dekomote/boop/fab/bom.csv

Comment | Designator | Footprint | LCSC Part #
10uF 25V | C1 | Capacitor_SMD:C_1206_3216Metric | C9807
1N5819HW-7-F | D1 | Diode_SMD:D_SOD-123 | C82544
1N4148W | D2,D3 | Diode_SMD:D_SOD-123 | C2099
1N4148WS | D4 | Diode_SMD:D_SOD-323 | C2128
5V_IN (+/-) | J1 | Connector_JST:JST_XH_B2B-XH-A_1x02_P2.50mm_Vertical | C158012
PWR_TO_MB | J2 | Connector_PinHeader_2.54mm:PinHeader_1x02_P2.54mm_Vertical | C492401
PWR_FROM_CASE | J3 | Connector_PinHeader_2.54mm:PinHeader_1x02_P2.54mm_Vertical | C492401
RST_TO_MB | J4 | Connector_PinHeader_2.54mm:PinHeader_1x02_P2.54mm_Vertical | C492401
RST_FROM_CASE | J5 | Connector_PinHeader_2.54mm:PinHeader_1x02_P2.54mm_Vertical | C492401
XIAO_LEFT_D0-D6 | J6 | Connector_PinSocket_2.54mm:PinSocket_1x07_P2.54mm_Vertical | C2897370
XIAO_RIGHT_5V-D7 | J7 | Connector_PinSocket_2.54mm:PinSocket_1x07_P2.54mm_Vertical | C2897370
PLED_FROM_MB | J8 | Connector_PinHeader_2.54mm:PinHeader_1x02_P2.54mm_Vertical | C492401
PLED_TO_CASE | J9 | Connector_PinHeader_2.54mm:PinHeader_1x02_P2.54mm_Vertical | C492401
G6K-2F-Y-TR DC4.5 | K1,K2 | Relay_SMD:Relay_DPDT_Omron_G6K-2F-Y | C397193
150 | R1,R2 | Resistor_SMD:R_0603_1608Metric | C22808
470 | R3 | Resistor_SMD:R_0603_1608Metric | C23179
10k | R4 | Resistor_SMD:R_0603_1608Metric | C25804
LTV-817S-TA1-D | U2,U3 | Package_DIP:SMDIP-4_W9.53mm | C114603
LTV-817S-TA1-C | U4 | Package_DIP:SMDIP-4_W9.53mm | C109227
