dekomote/boop/fab/BOM_full_with_wires.csv

Comment | Designator | Quantity | Footprint | LCSC Part # | Assembled by JLCPCB | Notes
10uF 25V | C1 | 1 | C_1206_3216Metric | C9807 | Yes
1N5819HW-7-F | D1 | 1 | D_SOD-123 | C82544 | Yes
1N4148W | D2,D3 | 2 | D_SOD-123 | C2099 | Yes
1N4148WS | D4 | 1 | D_SOD-323 | C2128 | Yes
5V_IN (+/-) | J1 | 1 | JST_XH_B2B-XH-A_1x02_P2.50mm_Vertical | C158012 | No - hand solder
PWR_TO_MB | J2 | 1 | PinHeader_1x02_P2.54mm_Vertical | C492401 | No - hand solder
PWR_FROM_CASE | J3 | 1 | PinHeader_1x02_P2.54mm_Vertical | C492401 | No - hand solder
RST_TO_MB | J4 | 1 | PinHeader_1x02_P2.54mm_Vertical | C492401 | No - hand solder
RST_FROM_CASE | J5 | 1 | PinHeader_1x02_P2.54mm_Vertical | C492401 | No - hand solder
XIAO_LEFT_D0-D6 | J6 | 1 | PinSocket_1x07_P2.54mm_Vertical | C2897370 | No - hand solder
XIAO_RIGHT_5V-D7 | J7 | 1 | PinSocket_1x07_P2.54mm_Vertical | C2897370 | No - hand solder
PLED_FROM_MB | J8 | 1 | PinHeader_1x02_P2.54mm_Vertical | C492401 | No - hand solder
PLED_TO_CASE | J9 | 1 | PinHeader_1x02_P2.54mm_Vertical | C492401 | No - hand solder
G6K-2F-Y-TR DC4.5 | K1,K2 | 2 | Relay_DPDT_Omron_G6K-2F-Y | C397193 | Yes
150 | R1,R2 | 2 | R_0603_1608Metric | C22808 | Yes
470 | R3 | 1 | R_0603_1608Metric | C23179 | Yes
10k | R4 | 1 | R_0603_1608Metric | C25804 | Yes
LTV-817S-TA1-D | U2,U3 | 2 | SMDIP-4_W9.53mm | C114603 | Yes
LTV-817S-TA1-C | U4 | 1 | SMDIP-4_W9.53mm | C109227 | Yes
Dupont wire, female-female, 20cm, 22AWG (1P) | W1,W2 | 2 | Wire | C368922 | No | J2 -> motherboard power switch header (polarity does not matter)
Dupont wire, female-female, 20cm, 22AWG (1P) | W3,W4 | 2 | Wire | C368922 | No | J4 -> motherboard reset switch header (polarity does not matter)
Dupont wire, female-female, 20cm, 22AWG (1P) | W5,W6 | 2 | Wire | C368922 | No | J8 -> motherboard power LED header: PLED+ to the pin marked +
Dupont wire, female-female, 20cm, 22AWG (1P) | W7,W8 | 2 | Wire | C368922 | No | Optional 5V feed. Cut one end off each, crimp into the XH housing below. Other ends go to motherboard USB header pin 1 (VCC, red) and pin 7 (GND, black)
JST XHP-2 housing (mates with J1) | P1 | 1 |  | C144401 | No | For the 5V feed cable
JST SXH-001T-P0.6 crimp terminal | P1 | 2 |  | C140573 | No | For the 5V feed cable, 22-28 AWG, needs a crimp tool
M3 standoff (length to suit your case) | H1-H4 | 4 |  |  | No | Not stocked by JLCPCB, buy anywhere
M3 screw (or nut + screw) | H1-H4 | 8 |  |  | No | Nylon is the safe choice, GND pour touches the hole edges
(no wire needed) | J3,J5,J9 | 3 |  |  |  | Plug straight into the case power, reset and power LED leads
