dekomote/boop/boop.kicad_pcb

## KiCad design boop.kicad_pcb (2026-10-27)

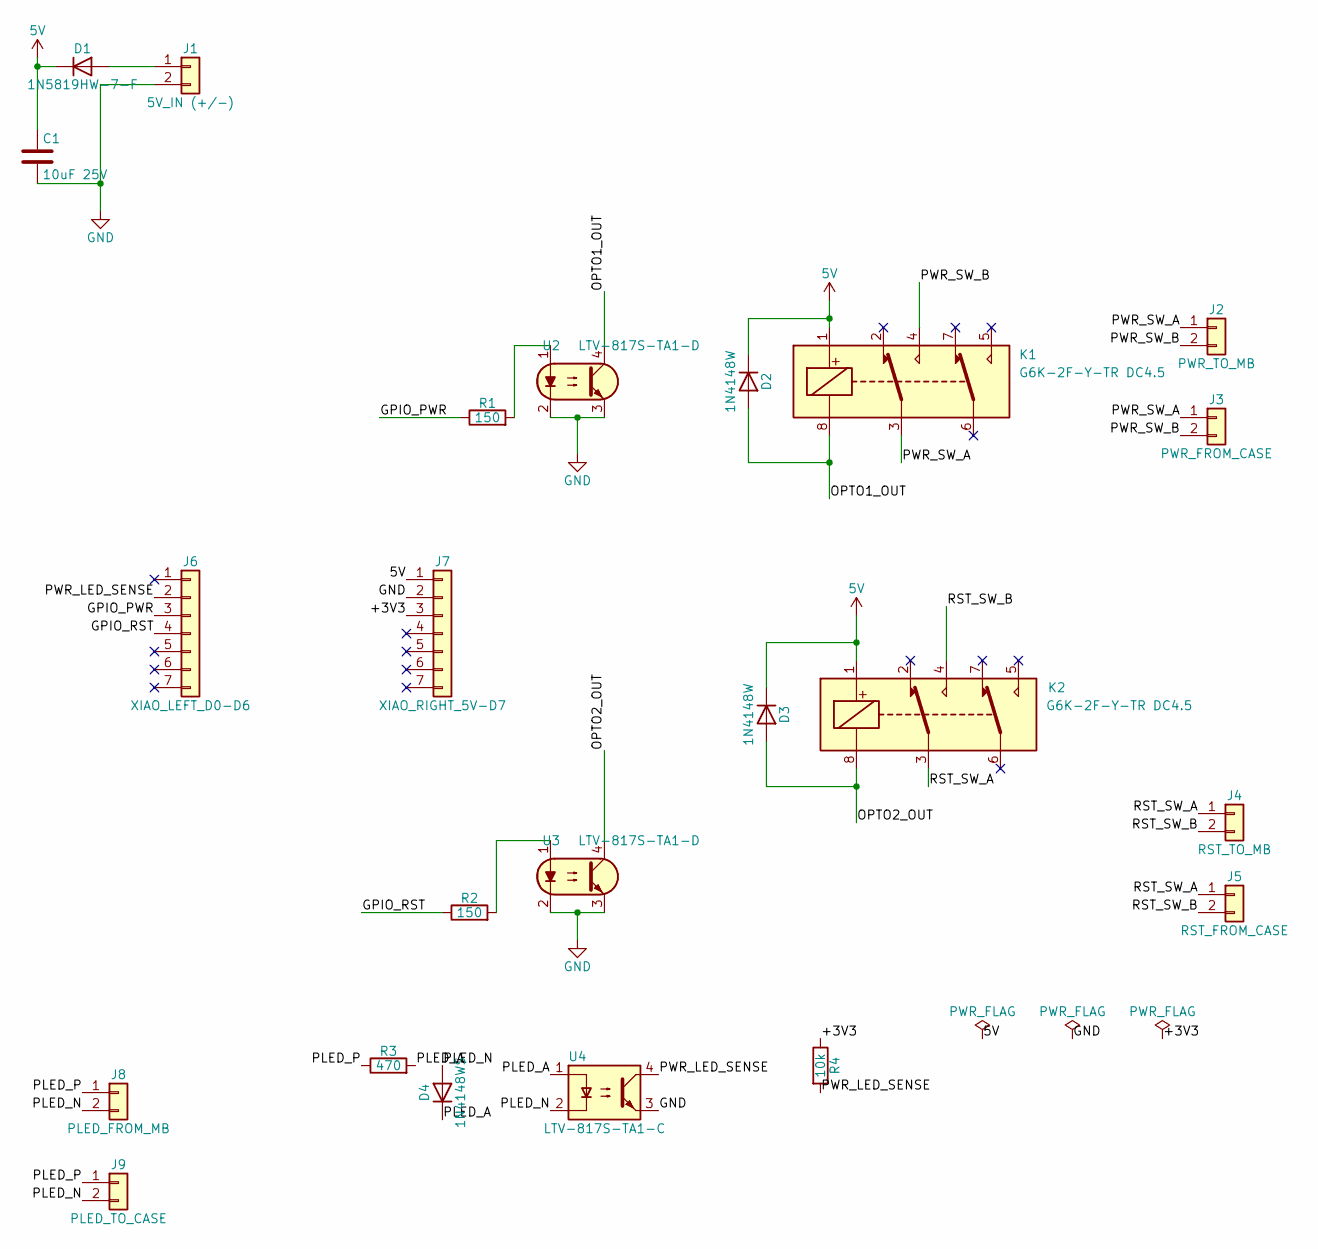
[picture p3: schematic boop.kicad_sch]

Parts:
C1: 10uF 25V; C_1206_3216Metric; LCSC C9807
D1: 1N5819HW-7-F; D_SOD-123; LCSC C82544
D2, D3: 1N4148W; D_SOD-123; LCSC C2099
D4: 1N4148WS; D_SOD-323; LCSC C2128
J1: 5V_IN (+/-); JST_XH_B2B-XH-A_1x02_P2.50mm_Vertical; LCSC C158012
J2: PWR_TO_MB; PinHeader_1x02_P2.54mm_Vertical; LCSC C492401
J3: PWR_FROM_CASE; PinHeader_1x02_P2.54mm_Vertical; LCSC C492401
J4: RST_TO_MB; PinHeader_1x02_P2.54mm_Vertical; LCSC C492401
J5: RST_FROM_CASE; PinHeader_1x02_P2.54mm_Vertical; LCSC C492401
J6: XIAO_LEFT_D0-D6; PinSocket_1x07_P2.54mm_Vertical; LCSC C2897370
J7: XIAO_RIGHT_5V-D7; PinSocket_1x07_P2.54mm_Vertical; LCSC C2897370
J8: PLED_FROM_MB; PinHeader_1x02_P2.54mm_Vertical; LCSC C492401
J9: PLED_TO_CASE; PinHeader_1x02_P2.54mm_Vertical; LCSC C492401
K1, K2: G6K-2F-Y-TR DC4.5; Relay_DPDT_Omron_G6K-2F-Y; LCSC C397193
R1, R2: 150; R_0603_1608Metric; LCSC C22808
R3: 470; R_0603_1608Metric; LCSC C23179
R4: 10k; R_0603_1608Metric; LCSC C25804
U2, U3: LTV-817S-TA1-D; SMDIP-4_W9.53mm; LCSC C114603
U4: LTV-817S-TA1-C; SMDIP-4_W9.53mm; LCSC C109227

Connections:
5V: C1.1, D1.1 (K), D2.1 (K), D3.1 (K), J7.1, K1.1, K2.1
/+3V3: J7.3, R4.1
/GPIO_PWR: J6.3, R1.1
/GPIO_RST: J6.4, R2.1
/OPTO1_OUT: D2.2 (A), K1.8, U2.4
/OPTO2_OUT: D3.2 (A), K2.8, U3.4
/PLED_A: D4.1 (K), R3.2, U4.1
/PLED_N: D4.2 (A), J8.2, J9.2, U4.2
/PLED_P: J8.1, J9.1, R3.1
/PWR_LED_SENSE: J6.2, R4.2, U4.4
/PWR_SW_A: J2.1, J3.1, K1.3
/PWR_SW_B: J2.2, J3.2, K1.4
/RST_SW_A: J4.1, J5.1, K2.3
/RST_SW_B: J4.2, J5.2, K2.4
GND: C1.2, J1.2, J7.2, U2.2, U2.3, U3.2, U3.3, U4.3
unnamed: D1.2 (A), J1.1
unnamed: R1.2, U2.1
unnamed: R2.2, U3.1

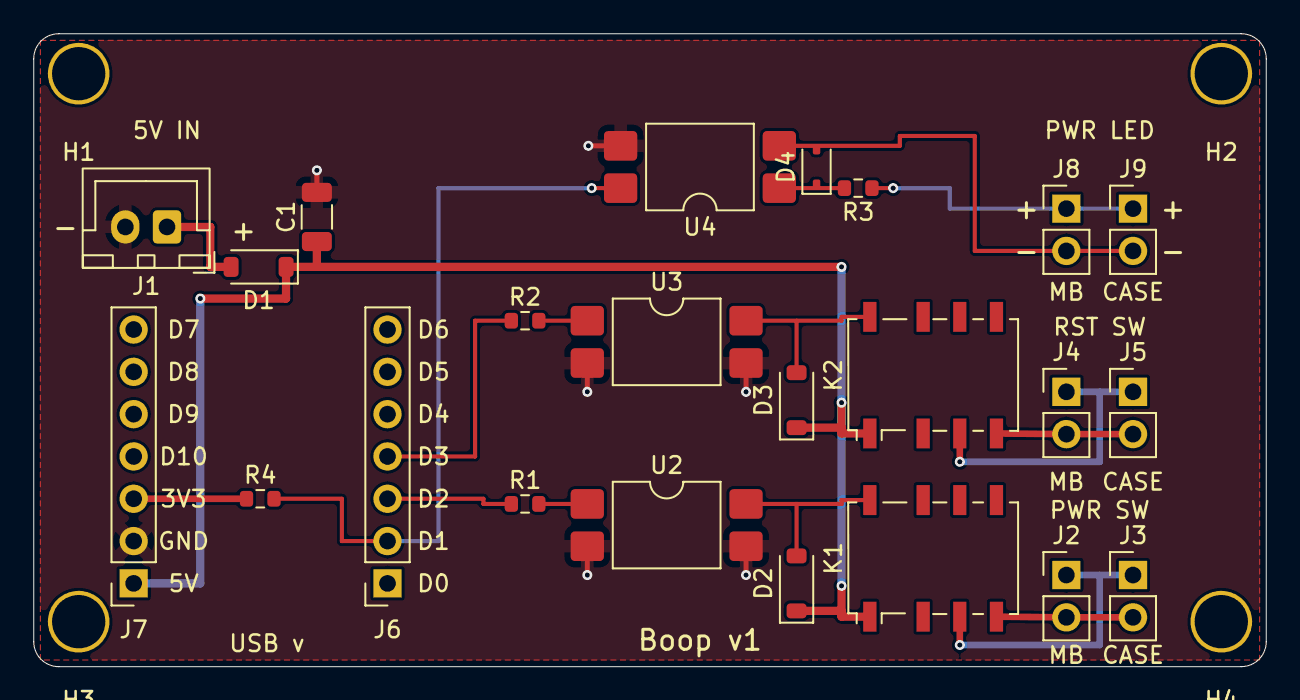
[picture p4: board boop.kicad_pcb from above]

Board: 2 copper layers, 74.0 x 38.0 mm, 27 parts (0 on the bottom side), 18 nets.

Other parts of the board:
H1, H2, H3, H4: MountingHole; MountingHole_3.2mm
